steveed/c128d-keyboard-case/docs/c128d-keyboard-reference.jpg

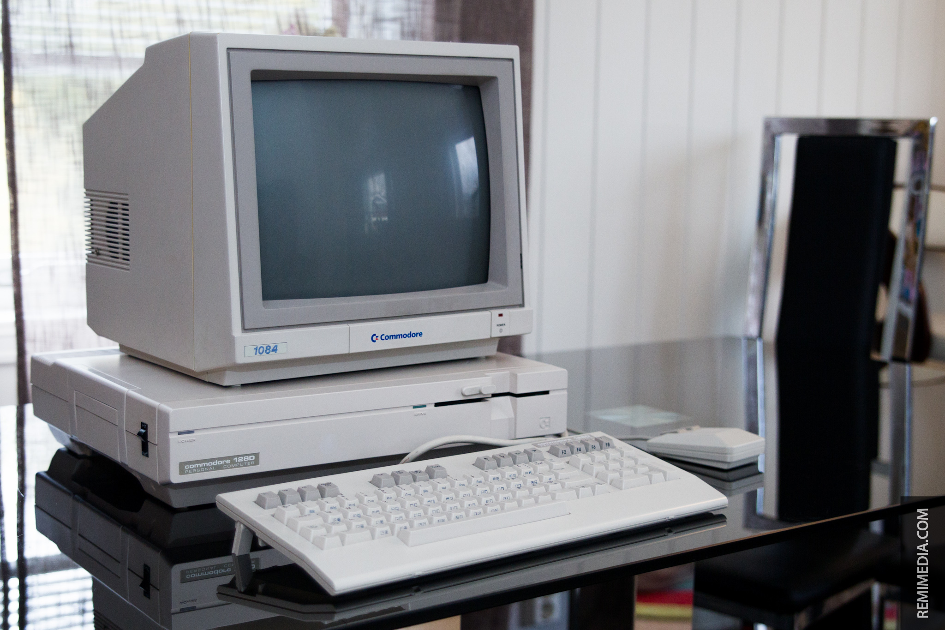
docs/c128d-keyboard-reference.jpg
