steveed/c128d-keyboard-case/stl/bezel_left.stl

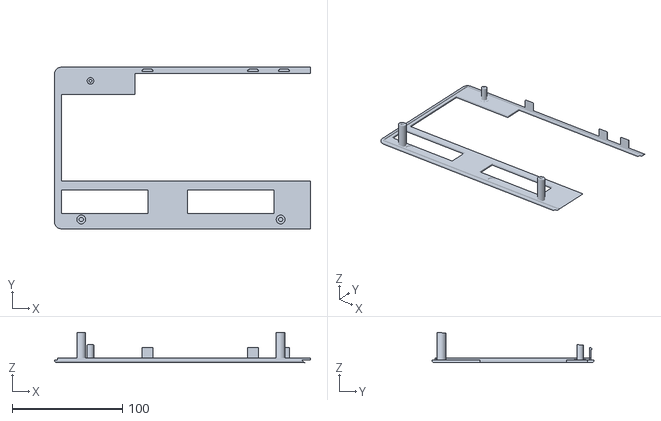
[picture p3: CAD file, 2026-09-30]
stl/bezel_left.stl
232.3 x 146.6 x 27.5
