steveed/c128d-keyboard-case/stl/bezel_right.stl

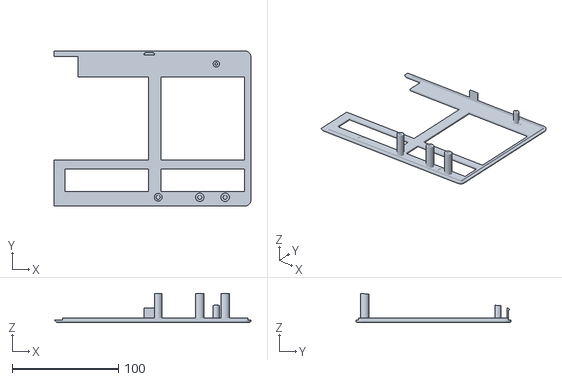
[picture p4: CAD file, 2026-09-30]
stl/bezel_right.stl
185.8 x 146.6 x 27.5
