steveed/c128d-keyboard-case/stl/tray_right.stl

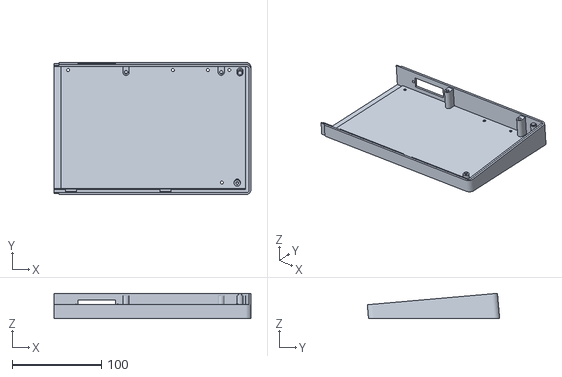
[picture p5: CAD file, 2026-09-30]
stl/tray_right.stl
221.0 x 148.6 x 28.4
