steveed/c128d-keyboard-case/stl/tray_left.stl

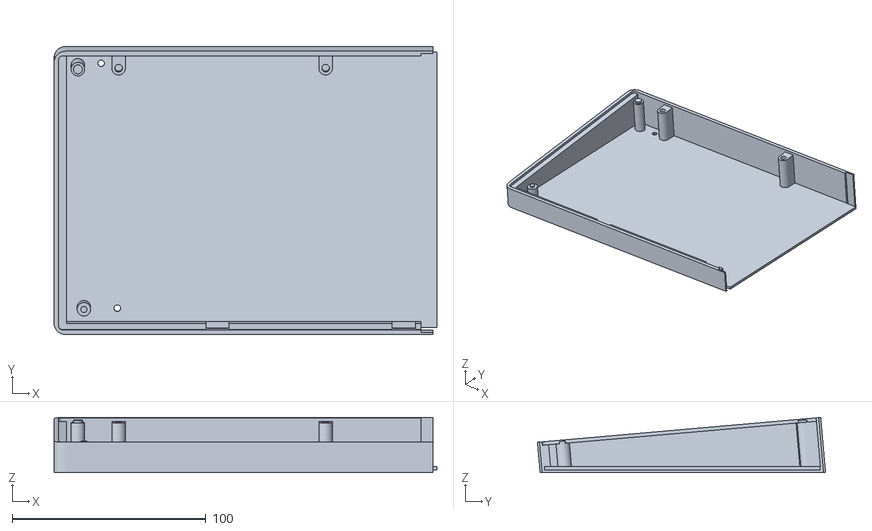
[picture p6: CAD file, 2026-09-30]
stl/tray_left.stl
197.5 x 148.6 x 28.4
